radensb/BLTouch-Installation-Guide-Archim2/BLTouchMount_LB_Dv3.stl

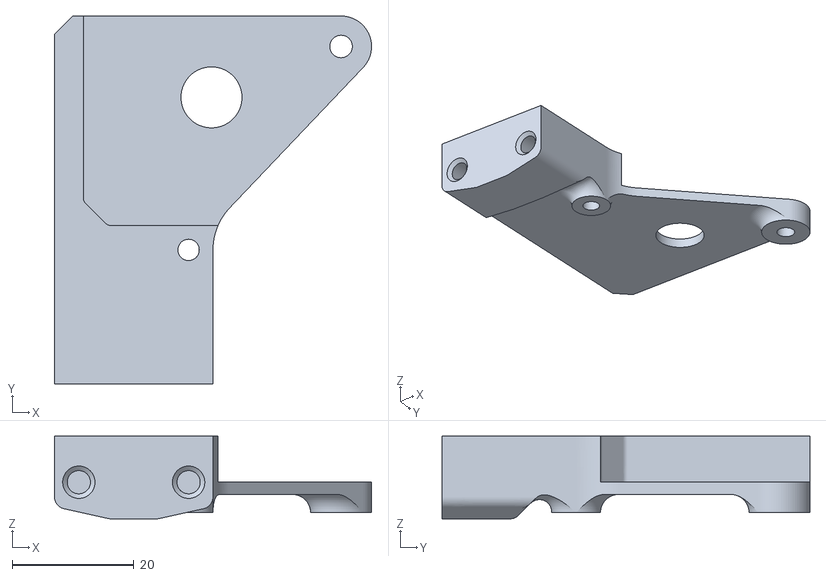
[picture p1: CAD file, 2020-02-14]
BLTouchMount_LB_Dv3.stl
52.0 x 60.3 x 13.6
